FreeSynth/FlybackConverter_Rev1/README.md

# FlybackConverter_Rev1

Repository of design files for a DC-DC switchmode power supply designed for use with modular synthesiser systems.

Design by FreeSynth - Licensed under CERN-OHL-W v2
