FreeSynth/FlybackConverter_Rev1/3D/FrontPCB_PNG_Layers/SMPS_FACEPLATE-B_Silkscreen.png

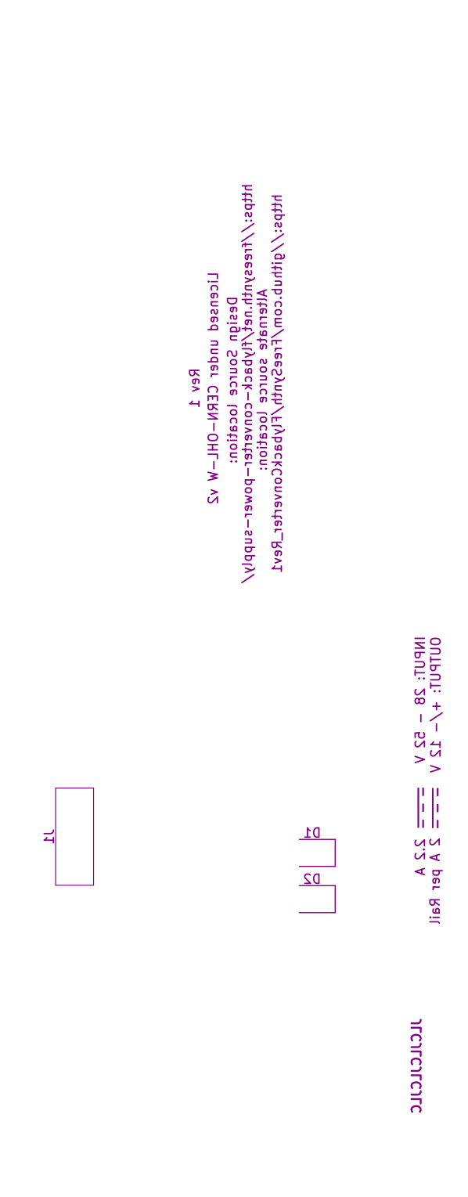
3D/FrontPCB_PNG_Layers/SMPS_FACEPLATE-B_Silkscreen.png
