FreeSynth/FlybackConverter_Rev1/3D/glb_textures_back/PCB_Back_RoughMetal.png

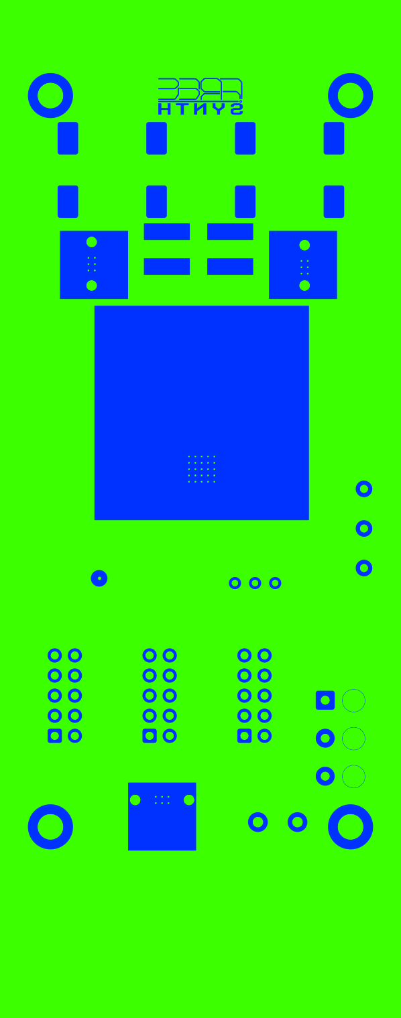
3D/glb_textures_back/PCB_Back_RoughMetal.png
