FreeSynth/FlybackConverter_Rev1/3D/glb_textures_front/Faceplate_Back_Colours.png

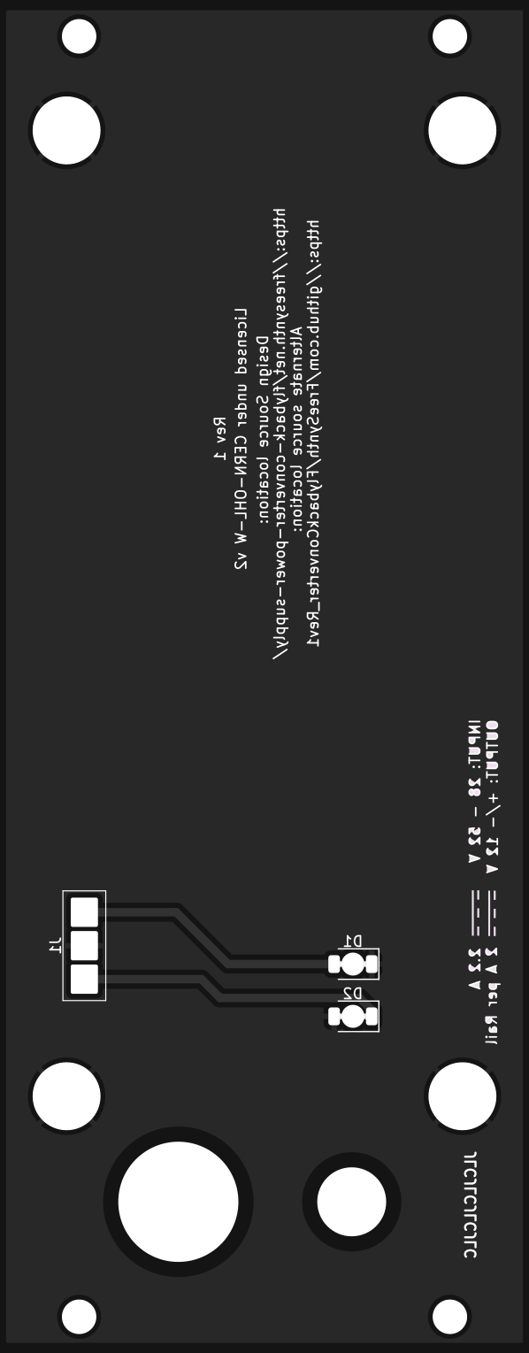
3D/glb_textures_front/Faceplate_Back_Colours.png
