FreeSynth/FlybackConverter_Rev1/3D/glb_textures_front/Faceplate_Front_Colours.png

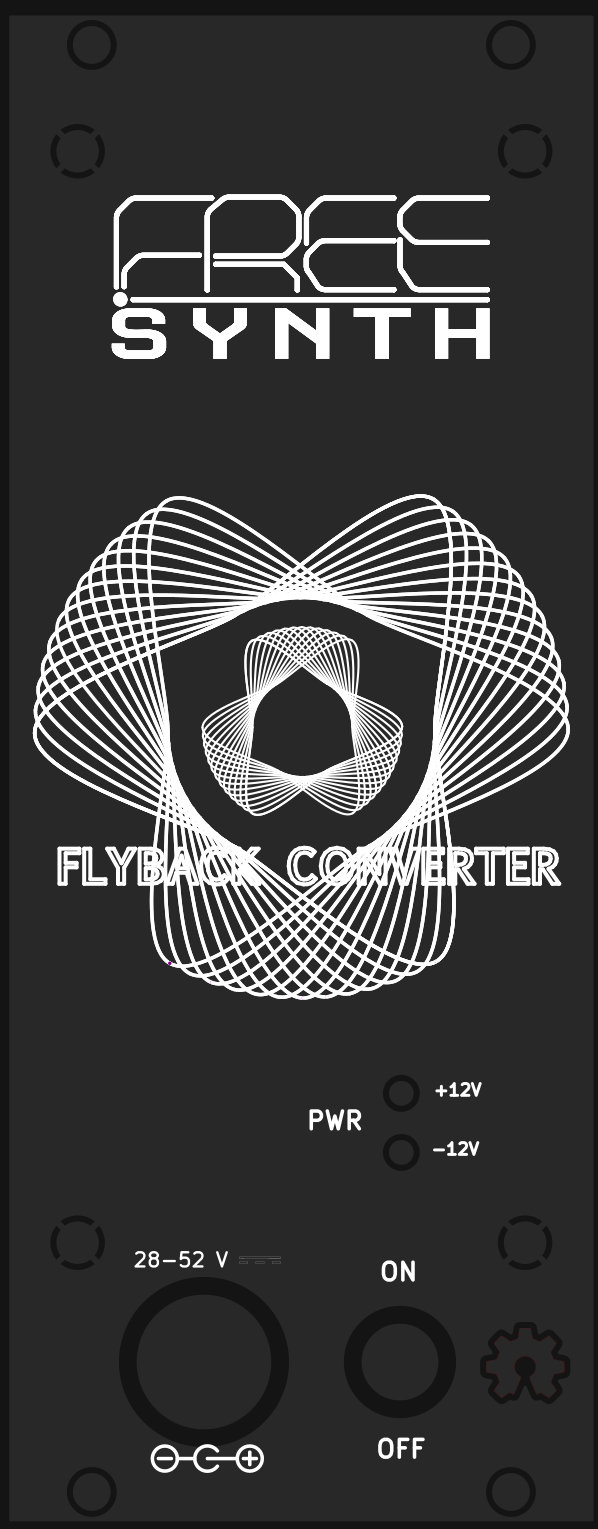
3D/glb_textures_front/Faceplate_Front_Colours.png
