FreeSynth/FlybackConverter_Rev1/3D/glb_textures_front/Faceplate_Front_RoughMetal.png

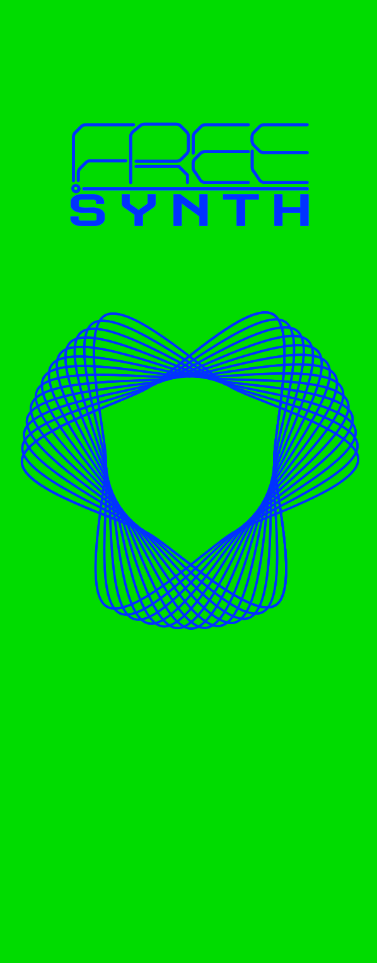
3D/glb_textures_front/Faceplate_Front_RoughMetal.png
