FreeSynth/FlybackConverter_Rev1/3D/RearPCB_PNG_Layers/SMPS-B_Cu.png

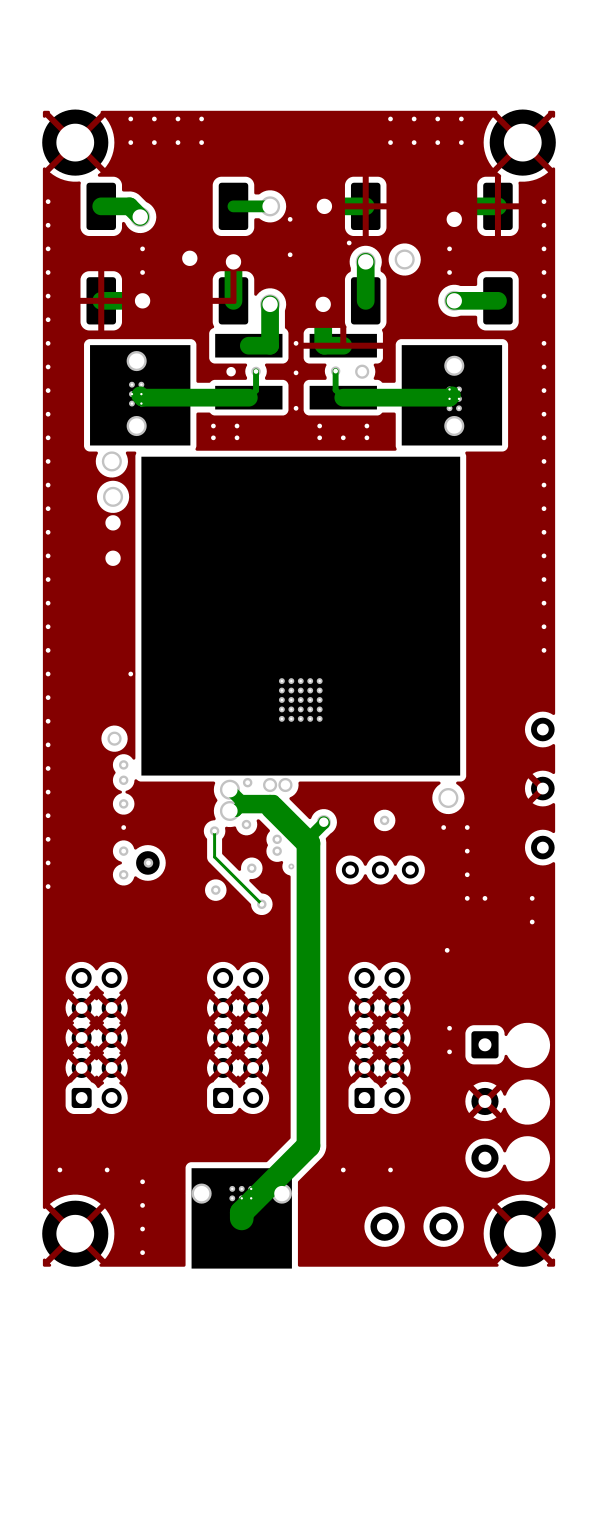
3D/RearPCB_PNG_Layers/SMPS-B_Cu.png
