FreeSynth/FlybackConverter_Rev1/3D/RearPCB_PNG_Layers/SMPS-F_Silkscreen.png

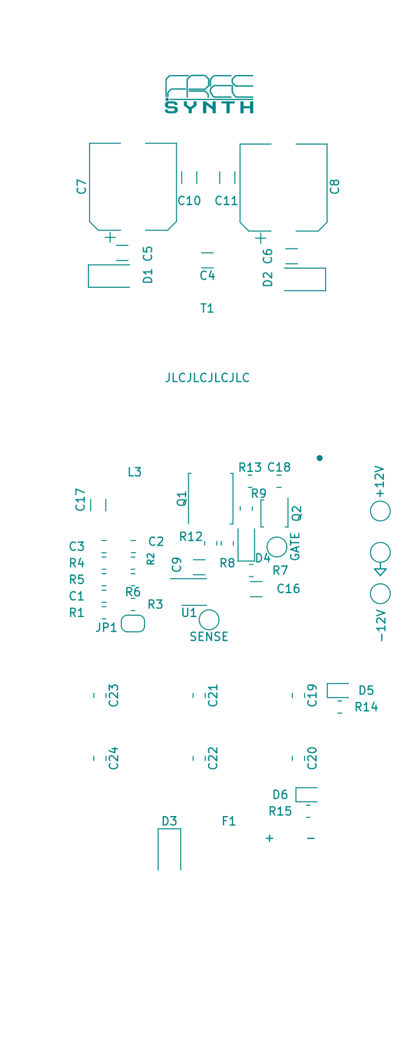
3D/RearPCB_PNG_Layers/SMPS-F_Silkscreen.png
