FreeSynth/FlybackConverter_Rev1/3D/Renders/Back.png

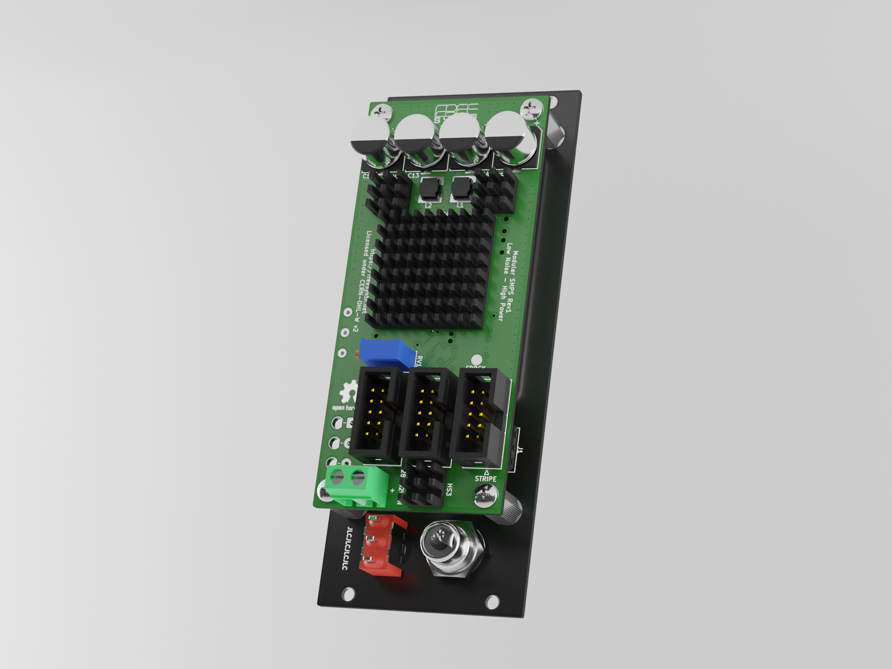
3D/Renders/Back.png
