FreeSynth/FlybackConverter_Rev1/3D/Renders/NoFaceplate.png

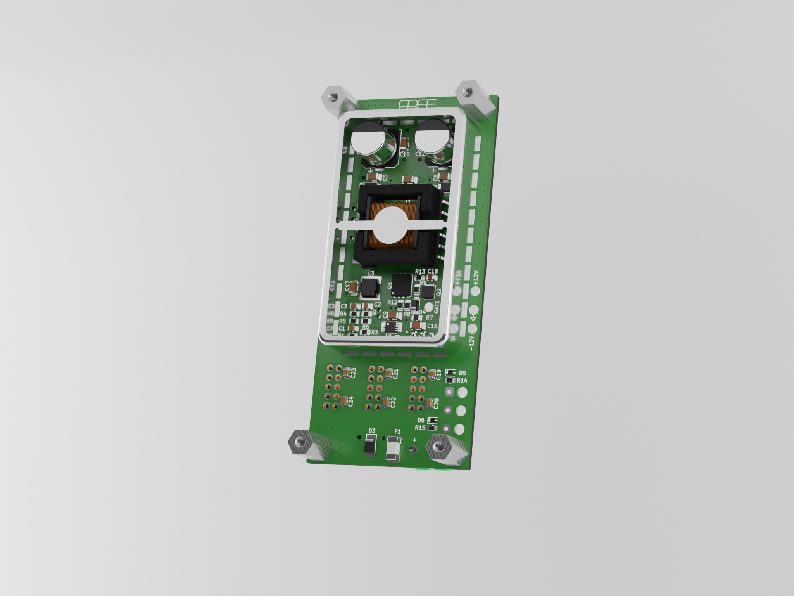
3D/Renders/NoFaceplate.png
