FreeSynth/FlybackConverter_Rev1/SPICE/Efficiency_12ohm_Load.png

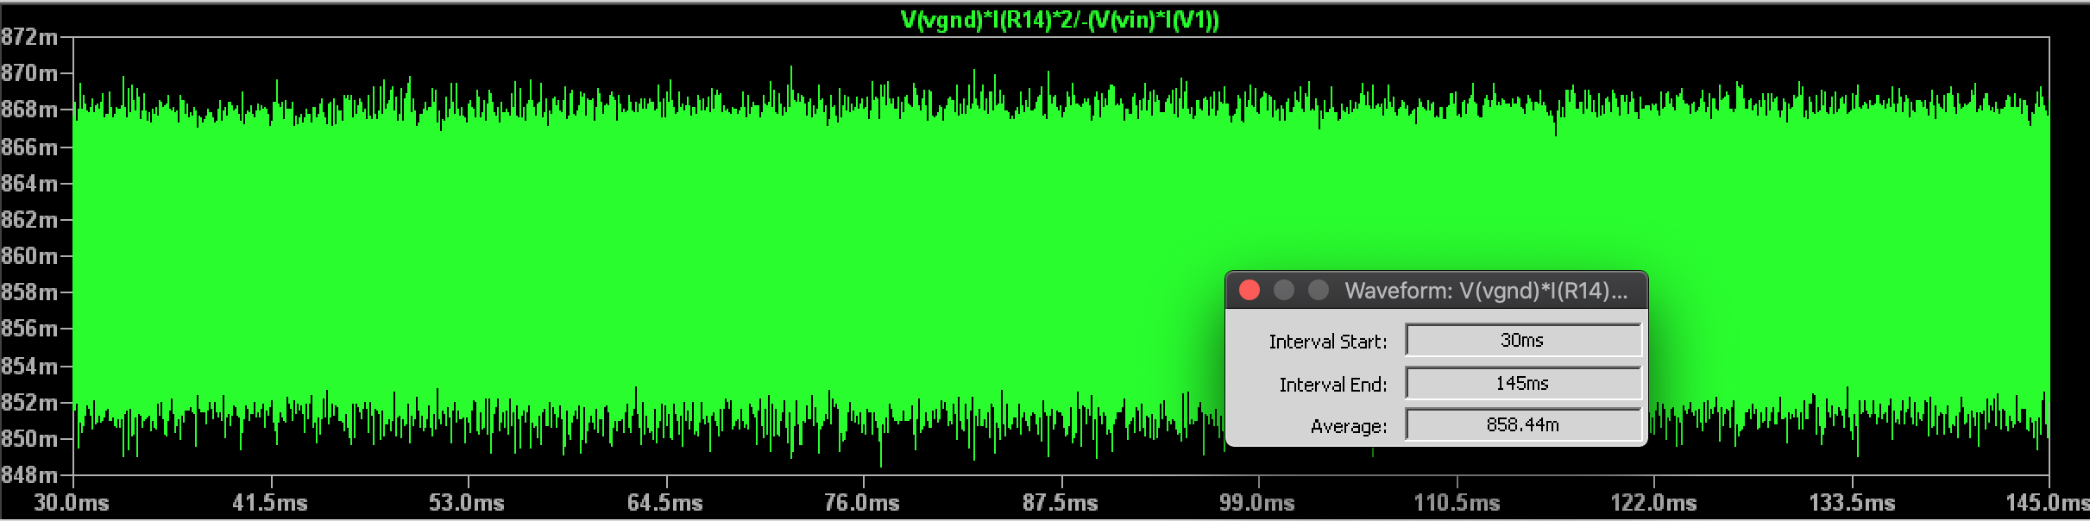
SPICE/Efficiency_12ohm_Load.png
