FreeSynth/FlybackConverter_Rev1/SPICE/Output_12ohm_Load.png

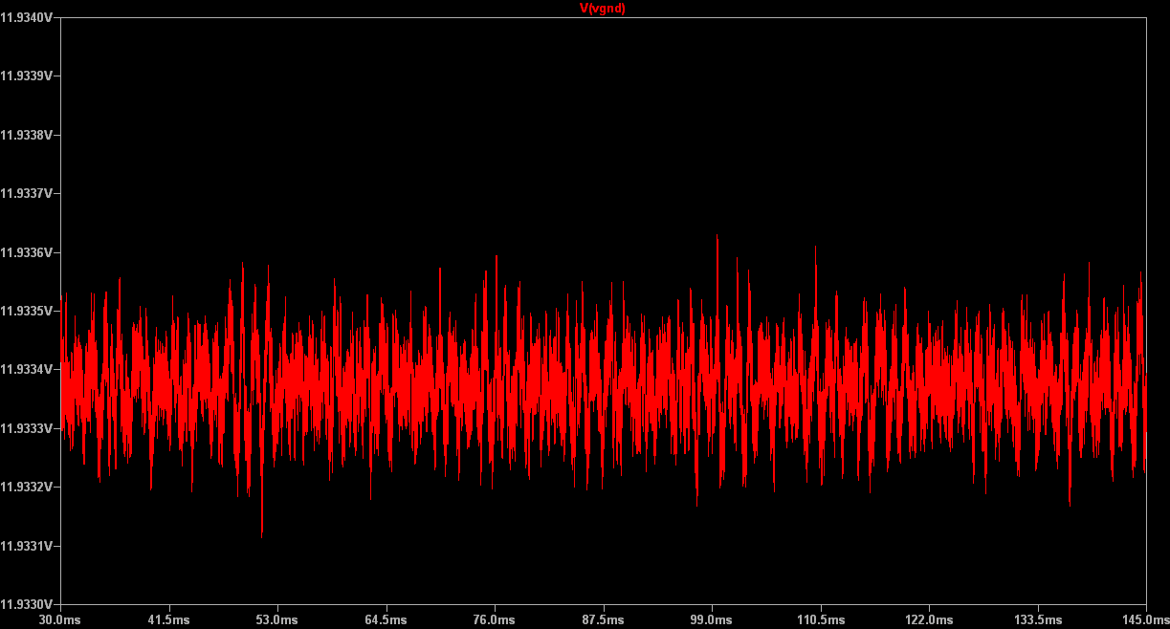
SPICE/Output_12ohm_Load.png
