FreeSynth/FlybackConverter_Rev1/SPICE/OutputFFT_12ohm_Load.png

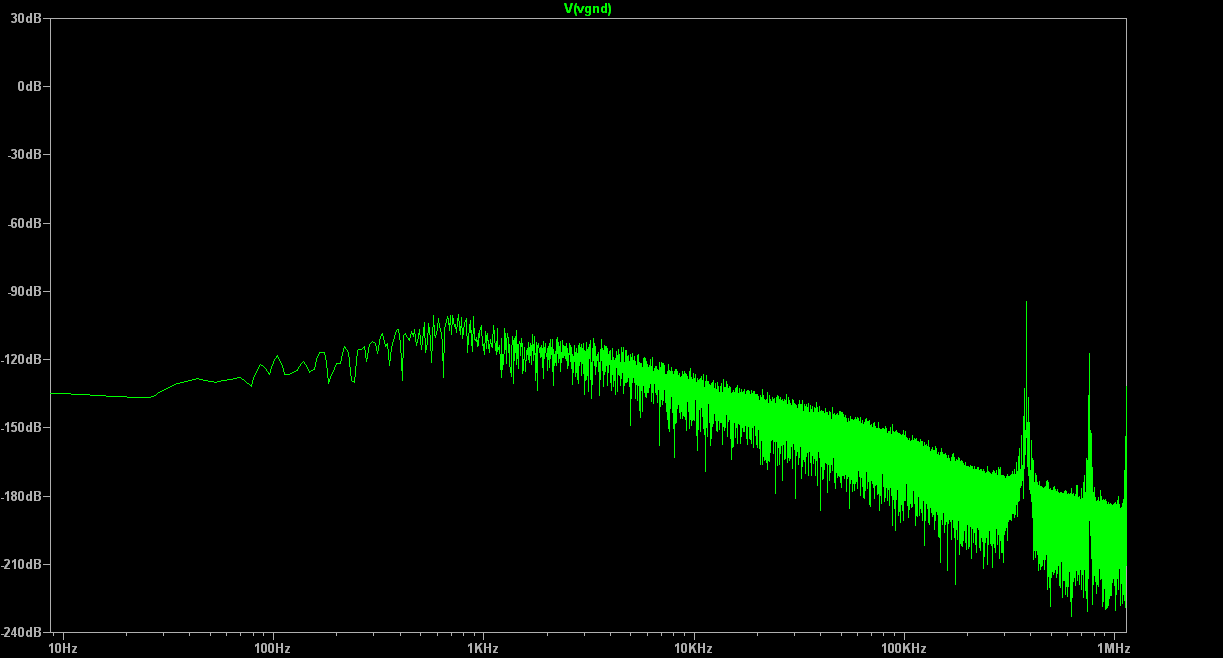
SPICE/OutputFFT_12ohm_Load.png
