FreeSynth/FlybackConverter_Rev1/(list of files, cad)

Other CAD files:
3D/Flyback_Rev1_glb_pipelining.blend
