FreeSynth/FlybackConverter_Rev1/Documentation/Flyback_PCB.pdf

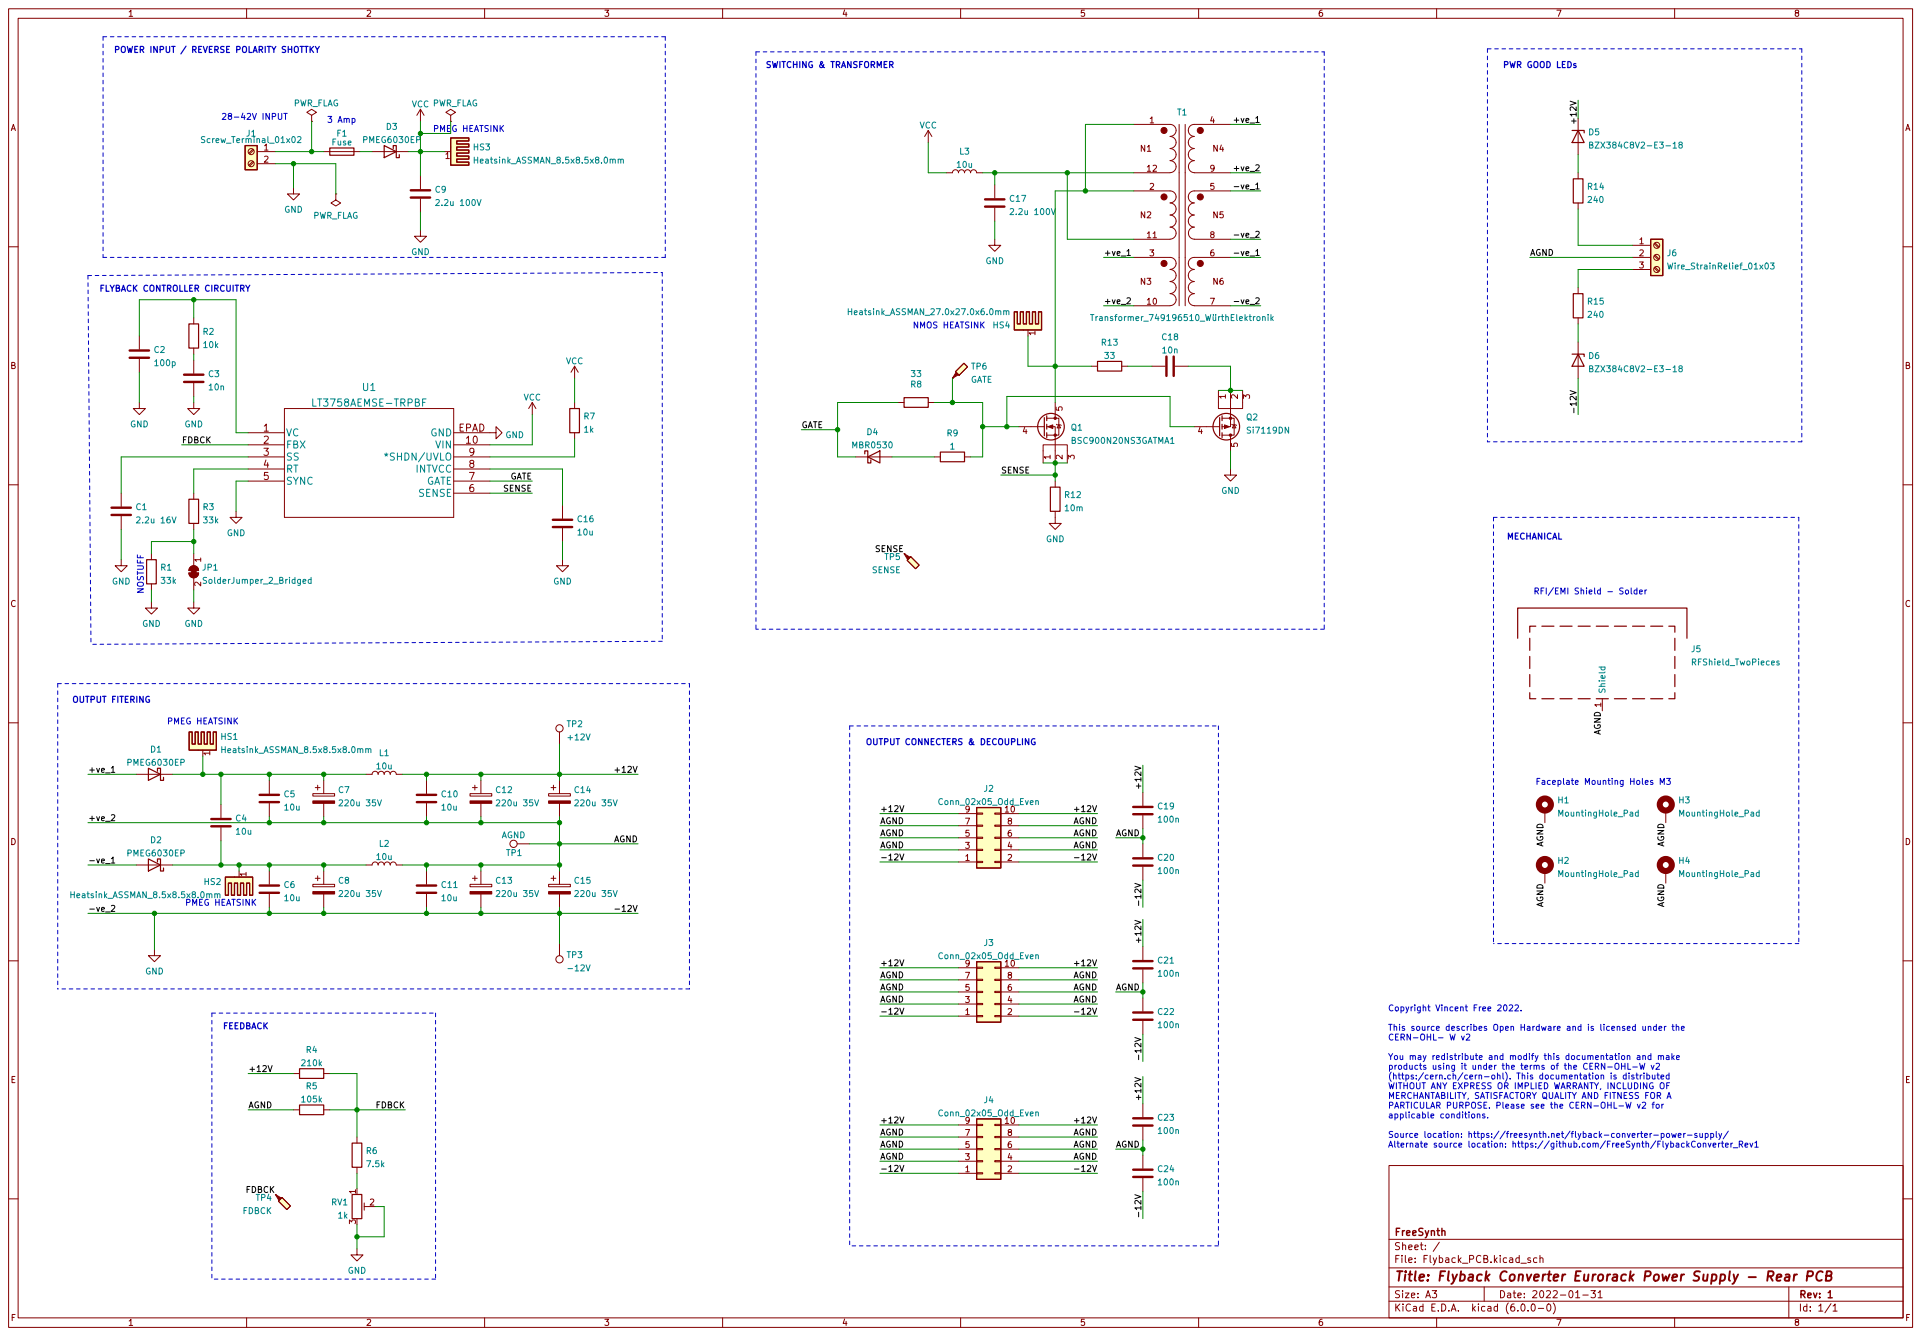
[picture p21: page 1]

PWR GOOD LEDs POWER INPUT / REVERSE POLARITY SHOTTKY

5 Q2 1 VC Si7119DN VIN 10 FBX 2 SS 3 RT 4 SYNC 5 SENSE 6 GATE 7

Alternate source location: https://github.com/FreeSynth/FlybackConverter_Rev1 NOSTUFF
33k GND

Faceplate Mounting Holes M3 PMEG HEATSINK

This source describes Open Hardware and is licensed under the CERN-OHL- W v2 You may redistribute and modify this documentation and make

products using it under the terms of the CERN-OHL-W v2
(https:/cern.ch/cern-ohl). This documentation is distributed WITHOUT ANY EXPRESS OR IMPLIED WARRANTY, INCLUDING OF MERCHANTABILITY, SATISFACTORY QUALITY AND FITNESS FOR A PARTICULAR PURPOSE. Please see the CERN-OHL-W v2 for applicable conditions.

Source location: https://freesynth.net/flyback-converter-power-supply/

Id: 1/1 Title: Flyback Converter Eurorack Power Supply - Rear PCB
