FreeSynth/FlybackConverter_Rev1/SPICE/FlybackConverter.asc

C1: cap; 10n; V=100 Irms=0.5 Rser=1 Lser=1n
C2: cap; 10µ; V=630 Irms=0 Rser=30m Lser=0
C3: cap; 220µ; Rser=0.15
C4: cap; 220µ; Rser=0.15
C5: cap; 10µ; V=10 Irms=9.29 Rser=0.00646575 Lser=0
C6: cap; 2.2µ; Rser=0.2
C7: cap; 2.2µ
C8: cap; 10n
C9: cap; 100p
C10: cap; 2.2µ; Rser=0.2
C11: cap; 10n
C12: cap; 10µ; V=630 Irms=0 Rser=30m Lser=0
C13: cap; 220µ; Rser=0.15
C14: cap; 220µ; Rser=0.15
C16: cap; 10µ; V=630 Irms=0 Rser=30m Lser=0
C17: cap; 10µ; V=630 Irms=0 Rser=30m Lser=0
C18: cap; 220µ; Rser=0.15
C19: cap; 220µ; Rser=0.15
D1: schottky; PMEG6030EVP
D2: schottky; PMEG6030EVP
D3: schottky; MBR0530L
D4: schottky; PMEG6030EVP
D5: zener; BZX84C8V2L
D6: zener; BZX84C8V2L
D7: LED; AOT-2015
D8: LED; AOT-2015
L1: ind2; 9.9µ; Ipk=2.1 Rser=30m
L2: ind2; 9.9µ; Ipk=2.1 Rser=30m
L3: ind2; 9.9µ; Ipk=2.1 Rser=30m
L4: ind2; 9.9µ; Ipk=2.1 Rser=30m
L5: ind; 10µ; Rser=56.4m
L6: ind; 2m
L7: ind2; 9.9µ; Ipk=2.1 Rser=30m
L8: ind2; 9.9µ; Ipk=2.1 Rser=30m
L9: ind; 10µ; Rser=56.4m
L10: ind; 10µ; Rser=56.4m
M1: pmos; Si7119DN
M2: nmos; BSC900N20NS3
R1: res; 33
R2: res; 4
R3: res; 150
R4: res; 10m
R5: res; 1k
R6: res; 2m
R7: res; 210k
R8: res; 10k
R9: res; 7.68k
R10: res; 105k
R11: res; 33k
R12: res; 33
R13: res; 1
R14: res; 4
R15: res; 200
R16: res; 200
U1: LT3758
V1: voltage; 42; Rser=0.5
Named nets: 0, vin, v+, vgnd, fdbck, vsw, vsense
K L1 L2 L3 L4 L7 L8 0.995
.tran 0 345m 200m startup uic
X5R
X5R
.SUBCKT PMEG6030EVP 1 2      
 R1 1 2 1.3E+006 
 D1 1 2 DIODE
*
*The resistor R1 does not  reflect 
*a physical device but improves 
*only modeling in the reverse 
*mode of operation.
*
.MODEL DIODE D  
 + IS = 3E-006   
 + N = 1 
 + BV = 72       
 + IBV = 0.003   
 + RS = 0.03     
 + CJO = 1.052E-009      
 + VJ = 0.3866   
 + M = 0.4916    
 + FC = 0
 + TT = 0
 + EG = 0.69     
 + XTI = 2       
 .ENDS
*
1K Trimmer
Copyright Vincent Free 2022.
 
This source describes Open Hardware and is licensed under the 
CERN-OHL- W v2
 
You may redistribute and modify this documentation and make 
products using it under the terms of the CERN-OHL-W v2 
(https:/cern.ch/cern-ohl). This documentation is distributed 
WITHOUT ANY EXPRESS OR IMPLIED WARRANTY, INCLUDING OF 
MERCHANTABILITY, SATISFACTORY QUALITY AND FITNESS FOR A 
PARTICULAR PURPOSE. Please see the CERN-OHL-W v2 for 
applicable conditions.
 

Source location: https://github.com/FreeSynth/FlybackConverter_Rev1
