FreeSynth/FlybackConverter_Rev1/KiCadProject_PCB/Flyback_PCB.kicad_pcb

## KiCad design KiCadProject_PCB/Flyback_PCB.kicad_pcb (2022-02-07)

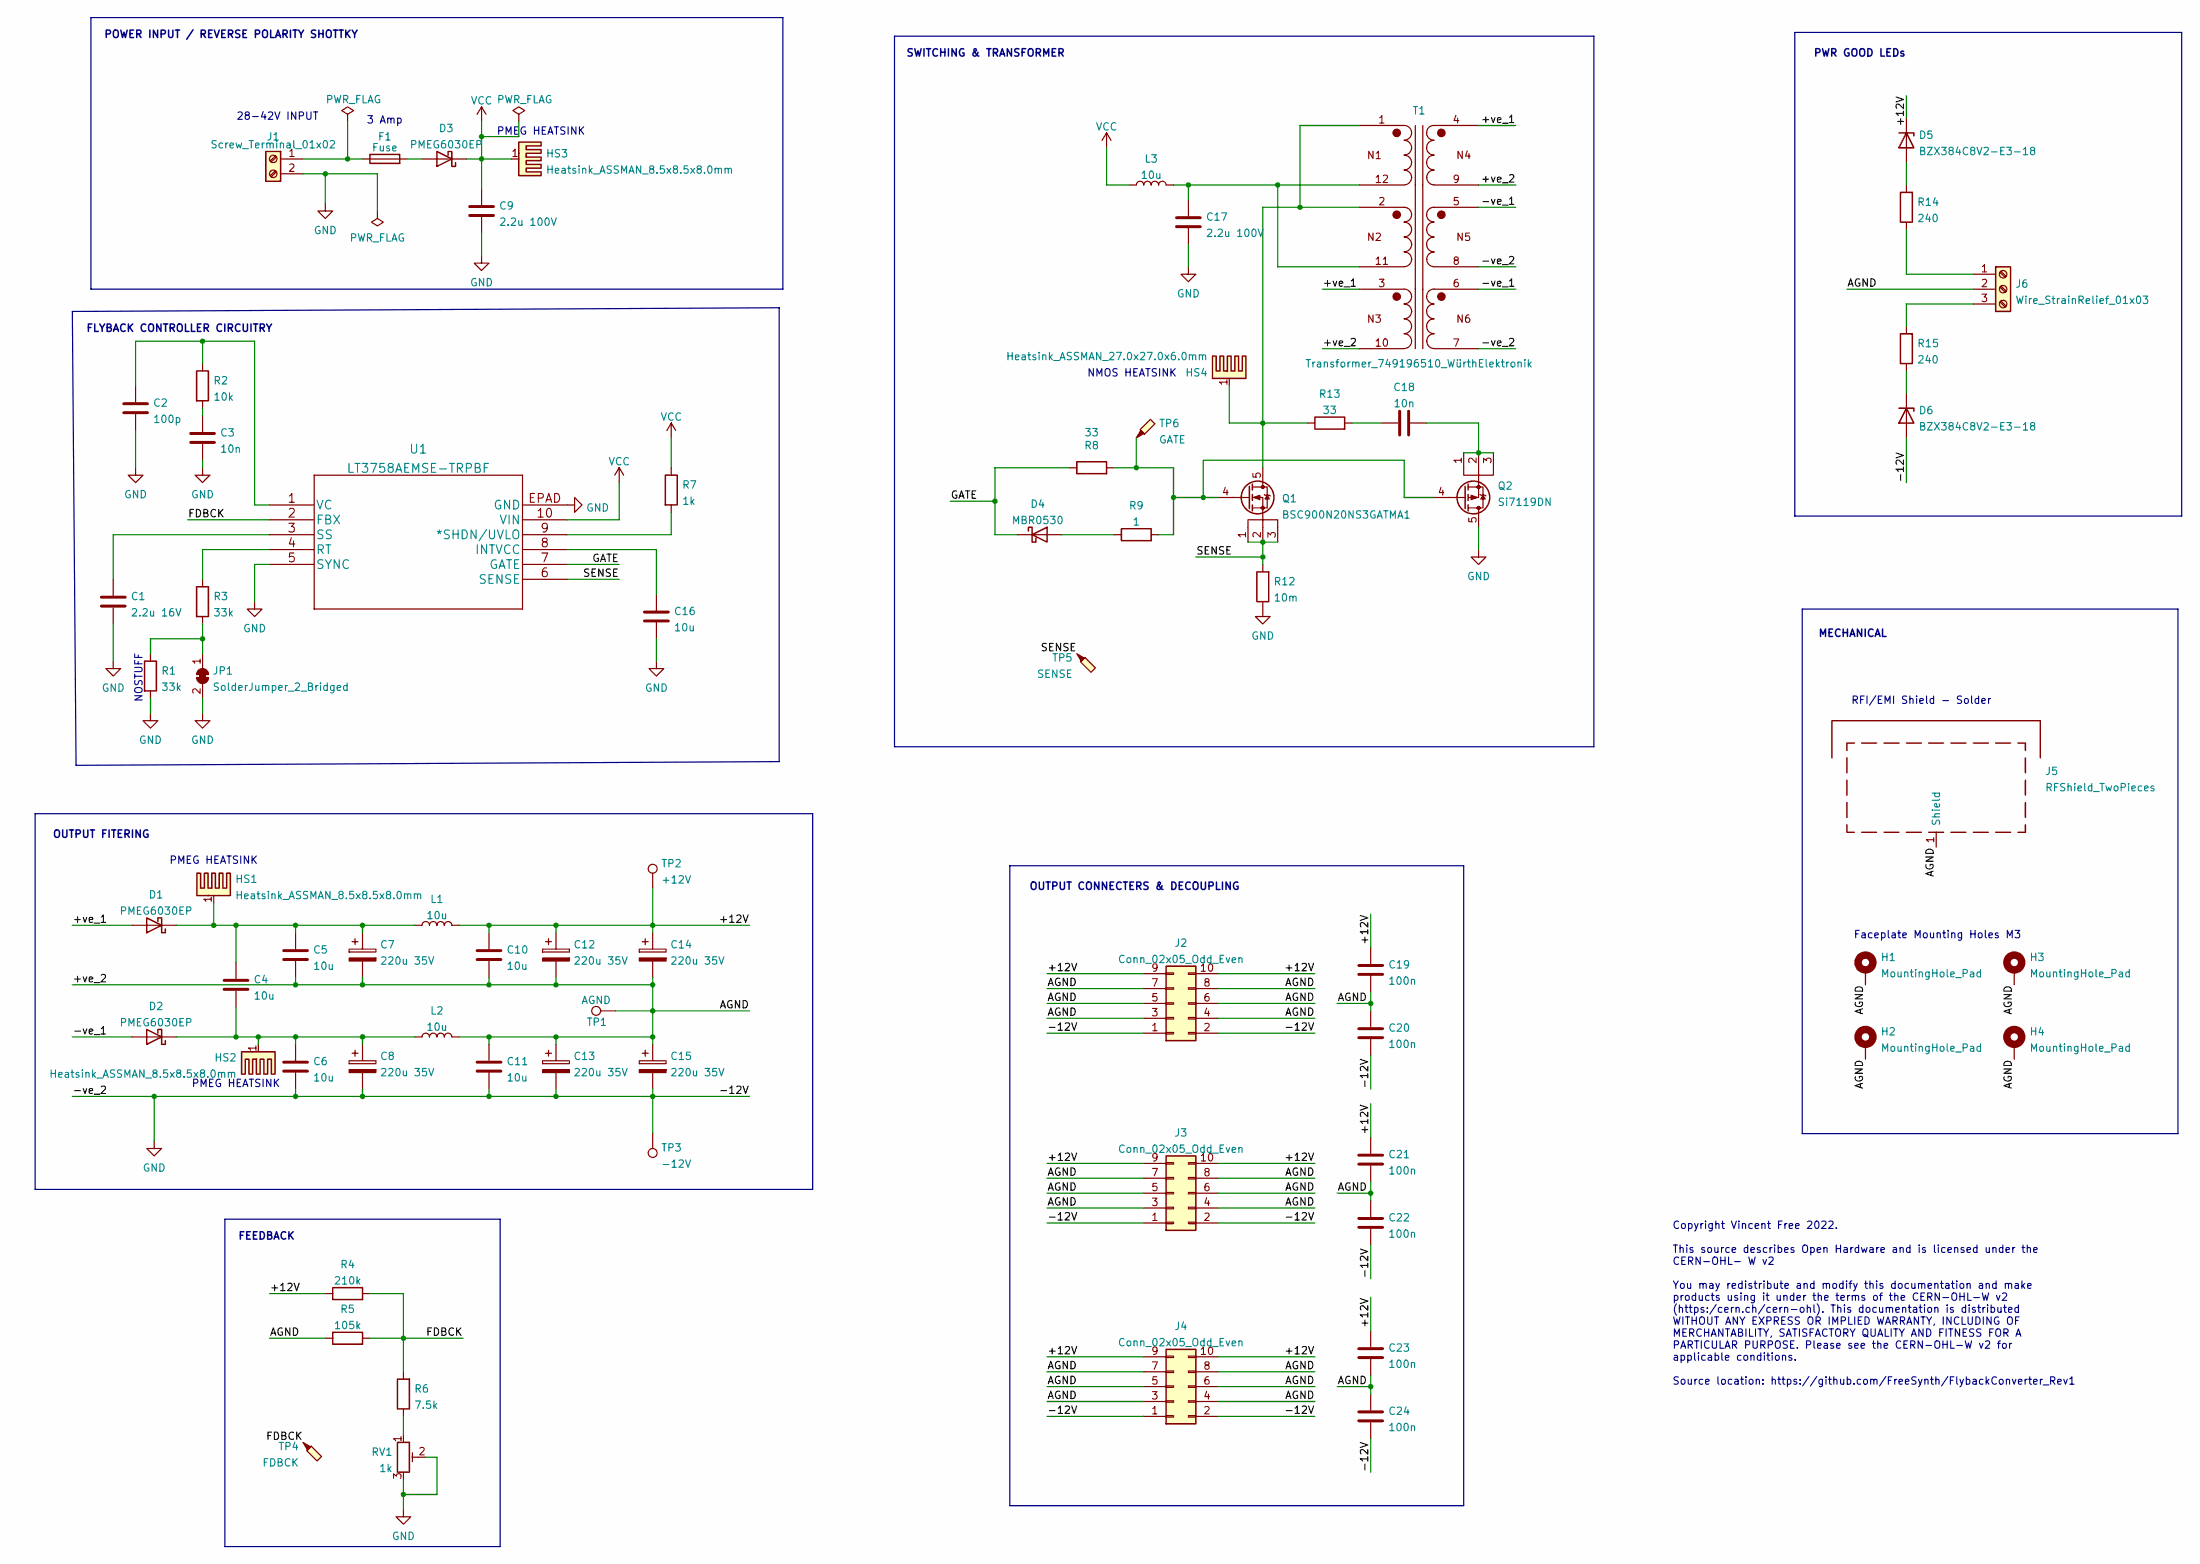
[picture p22: schematic Flyback_PCB.kicad_sch, Flyback Converter Eurorack Power Supply - Rear PCB]

Parts:
C1: 2.2u 16V; C_0805_2012Metric
C2: 100p; C_0805_2012Metric
C3, C18: 10n; C_0805_2012Metric
C4, C5, C6, C10, C11, C16: 10u; C_1206_3216Metric
C7, C8, C12, C13, C14, C15: 220u 35V; CP_Elec_10x10
C9, C17: 2.2u 100V; C_1206_3216Metric
C19, C20, C21, C22, C23, C24: 100n; C_0805_2012Metric
D1, D2, D3: PMEG6030EP; D_SOD-128
D4: MBR0530; D_SOD-123
D5, D6: BZX384C8V2-E3-18; D_SOD-323
F1: Fuse; 0680L-BelFuse
H1, H2, H3, H4: MountingHole_Pad; MountingHole_3.2mm_M3_DIN965_Pad
HS1, HS2, HS3: Heatsink_ASSMAN_8.5x8.5x8.0mm
HS4: Heatsink_ASSMAN_27.0x27.0x6.0mm
J1: Screw_Terminal_01x02; WürthElektronik_TermBlock_1x02_WR-TBLSeries1377_P5.00mm
J2, J3, J4: Conn_02x05_Odd_Even; IDC-Header_2x05_P2.54mm_Vertical
J5: RFShield_TwoPieces; MS638-10
J6: Wire_StrainRelief_01x03; SolderWire-0.5sqmm_1x03_P4.8mm_D0.9mm_OD2.3mm_Relief
JP1: SolderJumper_2_Bridged; SolderJumper-2_P1.3mm_Bridged_RoundedPad1.0x1.5mm
L1, L2, L3: 10u; BWVS00606045100ML1-YAGEO
Q1: BSC900N20NS3GATMA1; TDSON-8-1
Q2: Si7119DN; Vishay_PowerPAK_1212-8_Single
R1, R3: 33k; R_0805_2012Metric
R2: 10k; R_0805_2012Metric
R4: 210k; R_0805_2012Metric
R5: 105k; R_0805_2012Metric
R6: 7.5k; R_0805_2012Metric
R7: 1k; R_0805_2012Metric
R8, R13: 33; R_0805_2012Metric
R9: 1; R_0805_2012Metric
R12: 10m; R_0805_2012Metric
R14, R15: 240; R_0805_2012Metric
RV1: 1k; Potentiometer_Bourns_3296X_Horizontal
T1: Transformer_749196510_WürthElektronik
TP1: AGND; TestPoint_THTPad_D2.0mm_Drill1.0mm
TP2: +12V; TestPoint_THTPad_D2.0mm_Drill1.0mm
TP3: -12V; TestPoint_THTPad_D2.0mm_Drill1.0mm
TP4: FDBCK; TestPoint_Pad_D2.0mm
TP5: SENSE; TestPoint_Pad_D2.0mm
TP6: GATE; TestPoint_Pad_D2.0mm
U1: LT3758AEMSE-TRPBF; MSOP-10-1EP_3x3mm_P0.5mm_EP1.68x1.88mm

Connections:
/+12V: C10.2, C12.1, C14.1, C19.1, C21.1, C23.1, D5.1 (K), J2.9, J2.10, J3.9, J3.10, J4.9, J4.10, L1.2, R4.1, TP2.1
/+ve_1: D1.2 (A), T1.3, T1.4
/+ve_2: C5.1, C7.2, C10.1, C11.2, C12.2, C13.1, C14.2, C15.1, C19.2, C20.1, C21.2, C22.1, C23.2, C24.1, H1.1, H2.1, H3.1, H4.1, J2.3, J2.4, J2.5, J2.6, J2.7, J2.8, J3.3, J3.4, J3.5, J3.6, J3.7, J3.8, J4.3, J4.4, J4.5, J4.6, J4.7, J4.8, J5.1 (Shield), J6.2, L2.2, R5.1, T1.9, T1.10, TP1.1
/-ve_1: D2.2 (A), T1.5, T1.6
/FDBCK: R4.2, R5.2, R6.2, TP4.1, U1.2 (FBX)
/GATE: D4.1 (K), R8.1, U1.7 (GATE)
/SENSE: Q1.1 (S), Q1.2 (S), Q1.3 (S), R12.2, TP5.1, U1.6 (SENSE)
GND: C1.2, C2.2, C3.2, C6.1, C8.2, C9.2, C11.1, C13.2, C15.2, C16.1, C17.2, C20.2, C22.2, C24.2, D6.2 (A), J1.2, J2.1, J2.2, J3.1, J3.2, J4.1, J4.2, JP1.2 (B), Q2.5 (D), R1.2, R12.1, RV1.2, RV1.3, T1.7, T1.8, TP3.1, U1.5 (SYNC), U1.EPAD (GND)
unnamed: C1.1, U1.3 (SS)
unnamed: C2.1, R2.1, U1.1 (VC)
unnamed: C3.1, R2.2
unnamed: C4.1, C6.2, C8.1, D2.1 (K), HS2.1, L2.1
unnamed: C4.2, C5.2, C7.1, D1.1 (K), HS1.1, L1.1
unnamed: C16.2, U1.8 (INTVCC)
unnamed: C17.1, L3.2, T1.11, T1.12
unnamed: C18.1, R13.2
unnamed: C18.2, Q2.1 (S), Q2.2 (S), Q2.3 (S)
unnamed: D3.2 (A), F1.2
unnamed: D4.2 (A), R9.1
unnamed: D5.2 (A), R14.2
unnamed: D6.1 (K), R15.1
unnamed: F1.1, J1.1
unnamed: HS4.1, Q1.5 (D), R13.1, T1.1, T1.2
unnamed: J6.1, R14.1
unnamed: J6.3, R15.2
unnamed: JP1.1 (A), R1.1, R3.2
unnamed: Q1.4 (G), Q2.4 (G), R8.2, R9.2, TP6.1
unnamed: R3.1, U1.4 (RT)
unnamed: R6.1, RV1.1
unnamed: R7.2, U1.9 (*SHDN/UVLO)
VCC: C9.1, D3.1 (K), HS3.1, L3.1, R7.1, U1.10 (VIN)

Notes on the sheet:
28-42V INPUT
PWR GOOD LEDs
OUTPUT CONNECTERS & DECOUPLING
NMOS HEATSINK
MECHANICAL
SWITCHING & TRANSFORMER
PMEG HEATSINK
Faceplate Mounting Holes M3
FEEDBACK
OUTPUT FITERING
NOSTUFF
Copyright Vincent Free 2022. This source describes Open Hardware and is licensed under the CERN-OHL- W v2 You may redistribute and modify this documentation and make products using it under the terms of the CERN-OHL-W v2 (https:/cern.ch/cern-ohl). This documentation is distributed WITHOUT ANY EXPRE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
3 Amp
FLYBACK CONTROLLER CIRCUITRY
RFI/EMI Shield - Solder
POWER INPUT / REVERSE POLARITY SHOTTKY

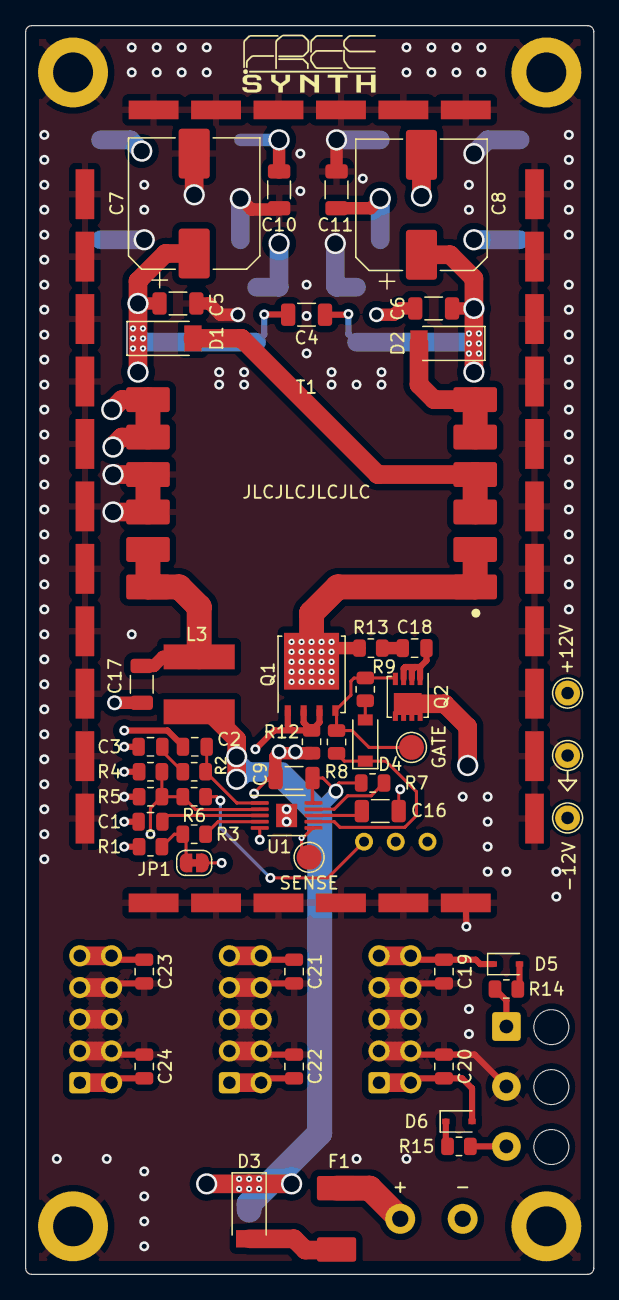
[picture p23: board Flyback_PCB.kicad_pcb from above]

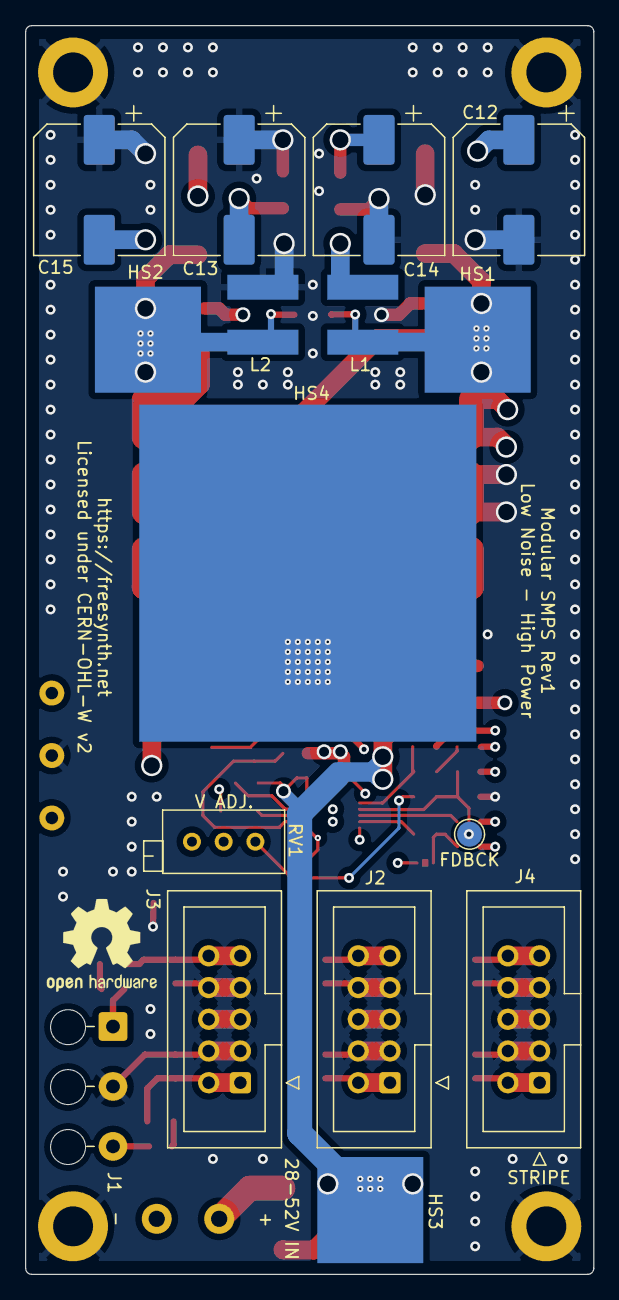
[picture p24: board Flyback_PCB.kicad_pcb from below]

Board: 4 copper layers, 45.5 x 100.0 mm, 73 parts (17 on the bottom side), 31 nets.
