FreeSynth/FlybackConverter_Rev1/KiCadProject_Faceplate/Flyback_Faceplate.kicad_pcb

## KiCad design KiCadProject_Faceplate/Flyback_Faceplate.kicad_pcb (2022-02-07)

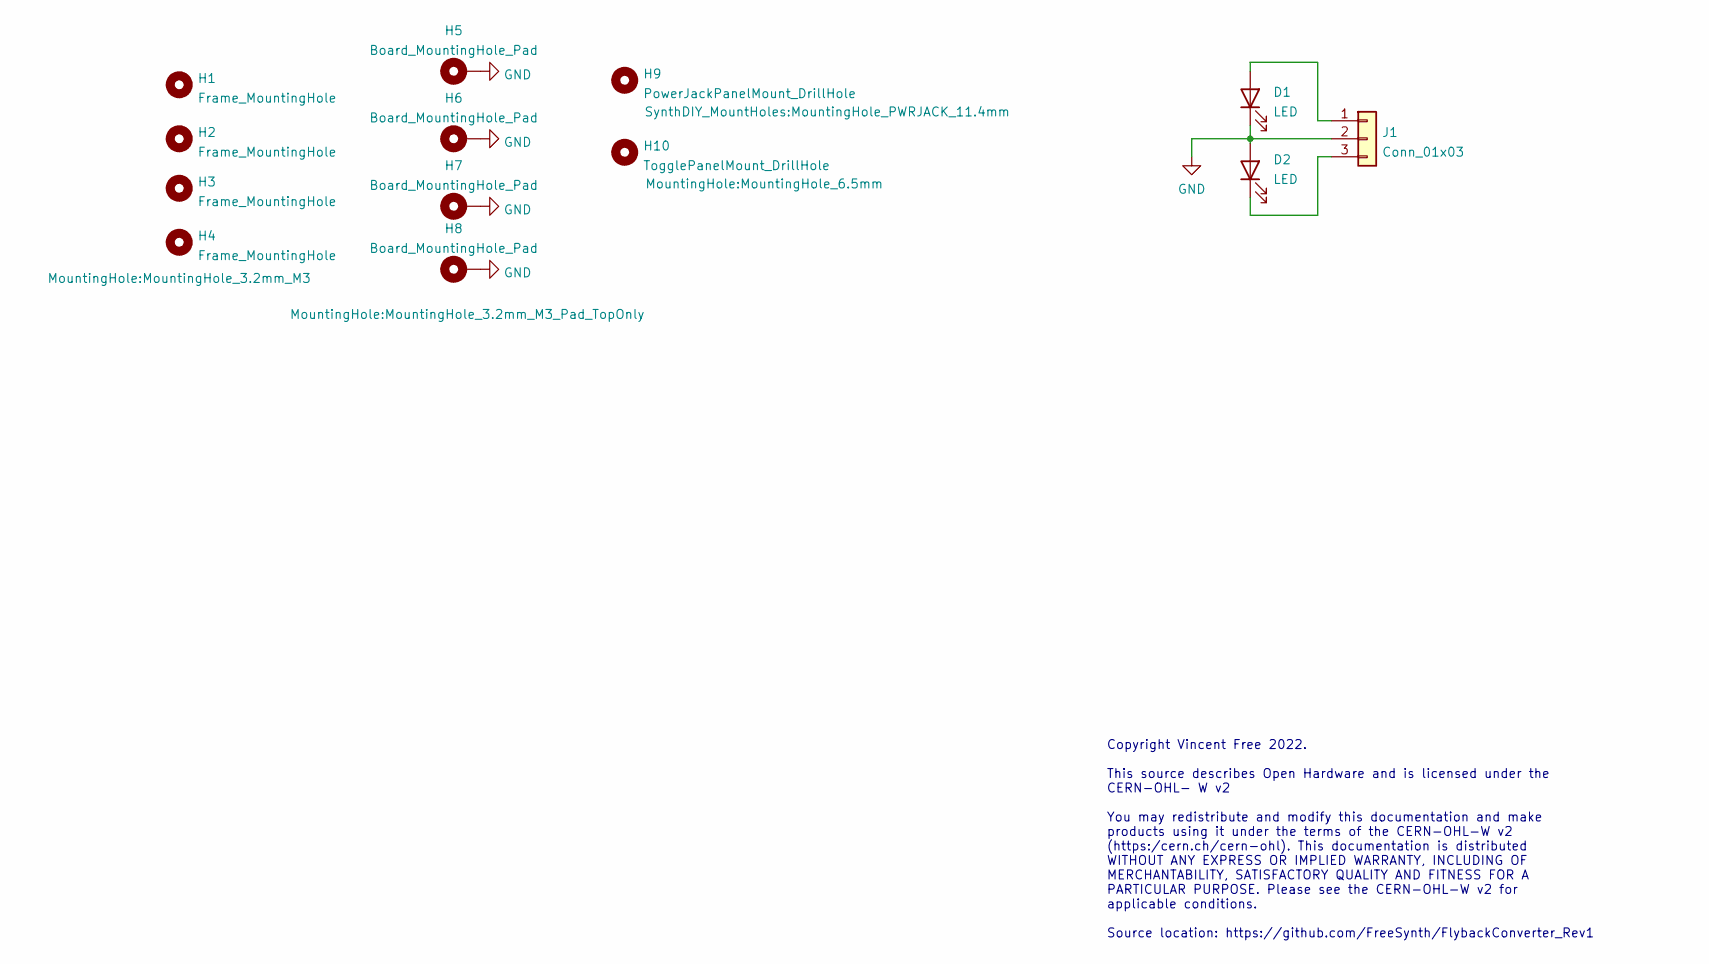
[picture p25: schematic Flyback_Faceplate.kicad_sch, Flyback Converter Eurorack Power Supply - Front PCB]

Parts:
D1, D2: LED; LED_156120VS75300_Würth_ReverseMount
H1, H2, H3, H4: Frame_MountingHole; MountingHole_3.2mm_M3
H5, H6, H7, H8: Board_MountingHole_Pad; MountingHole_3.2mm_M3_Pad_TopOnly
H9: PowerJackPanelMount_DrillHole; MountingHole_PWRJACK_11.4mm
H10: TogglePanelMount_DrillHole; MountingHole_6.5mm
J1: Conn_01x03; Kyocera_3pos_WireToBoard

Connections:
GND: D1.1 (K), D2.2 (A), H5.1, H6.1, H7.1, H8.1, J1.2
unnamed: D1.2 (A), J1.1
unnamed: D2.1 (K), J1.3

Notes on the sheet:
Copyright Vincent Free 2022. This source describes Open Hardware and is licensed under the CERN-OHL- W v2 You may redistribute and modify this documentation and make products using it under the terms of the CERN-OHL-W v2 (https:/cern.ch/cern-ohl). This documentation is distributed WITHOUT ANY EXPRE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

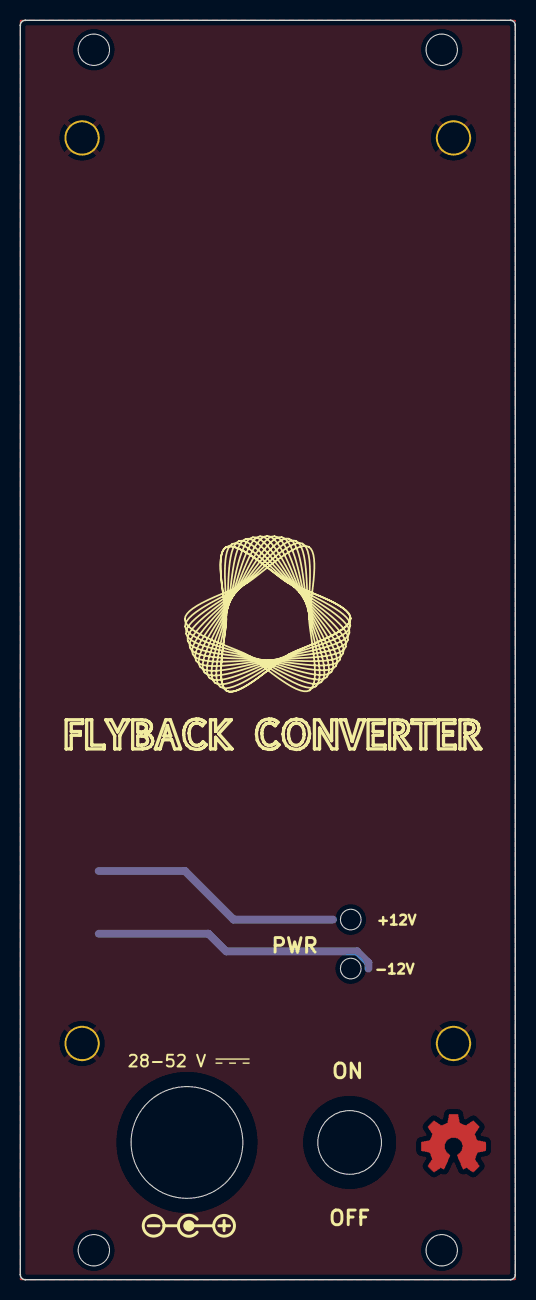
[picture p26: board Flyback_Faceplate.kicad_pcb from above]

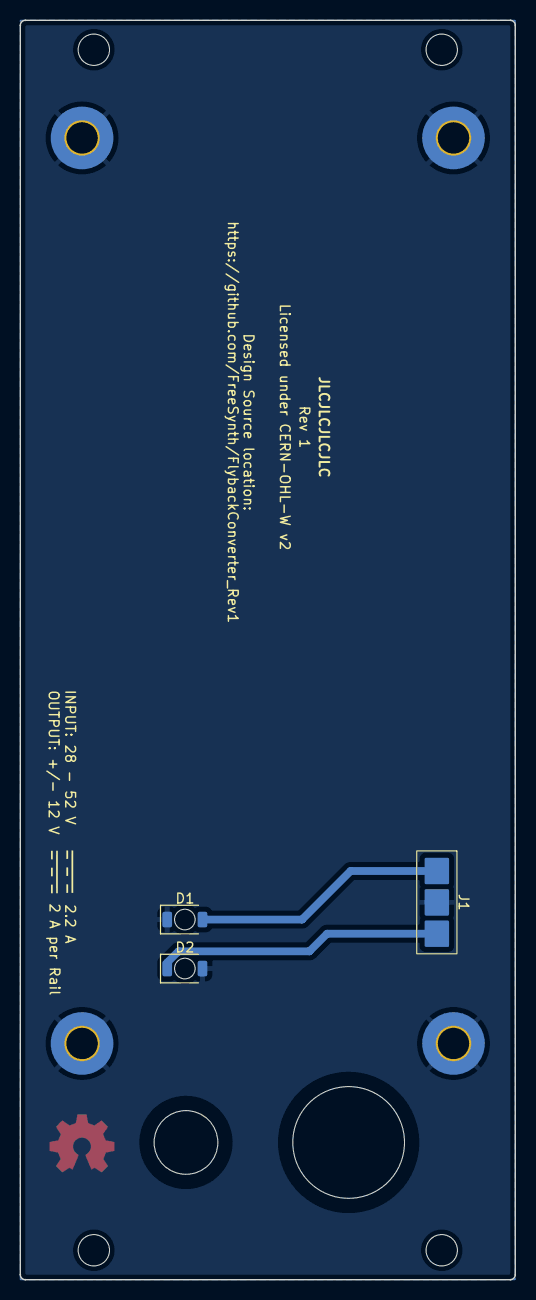
[picture p27: board Flyback_Faceplate.kicad_pcb from below]

Board: 2 copper layers, 50.5 x 128.5 mm, 13 parts (7 on the bottom side), 3 nets.
